corgiolu-labs/uav-lora-transponder/docs/images/schematic.png

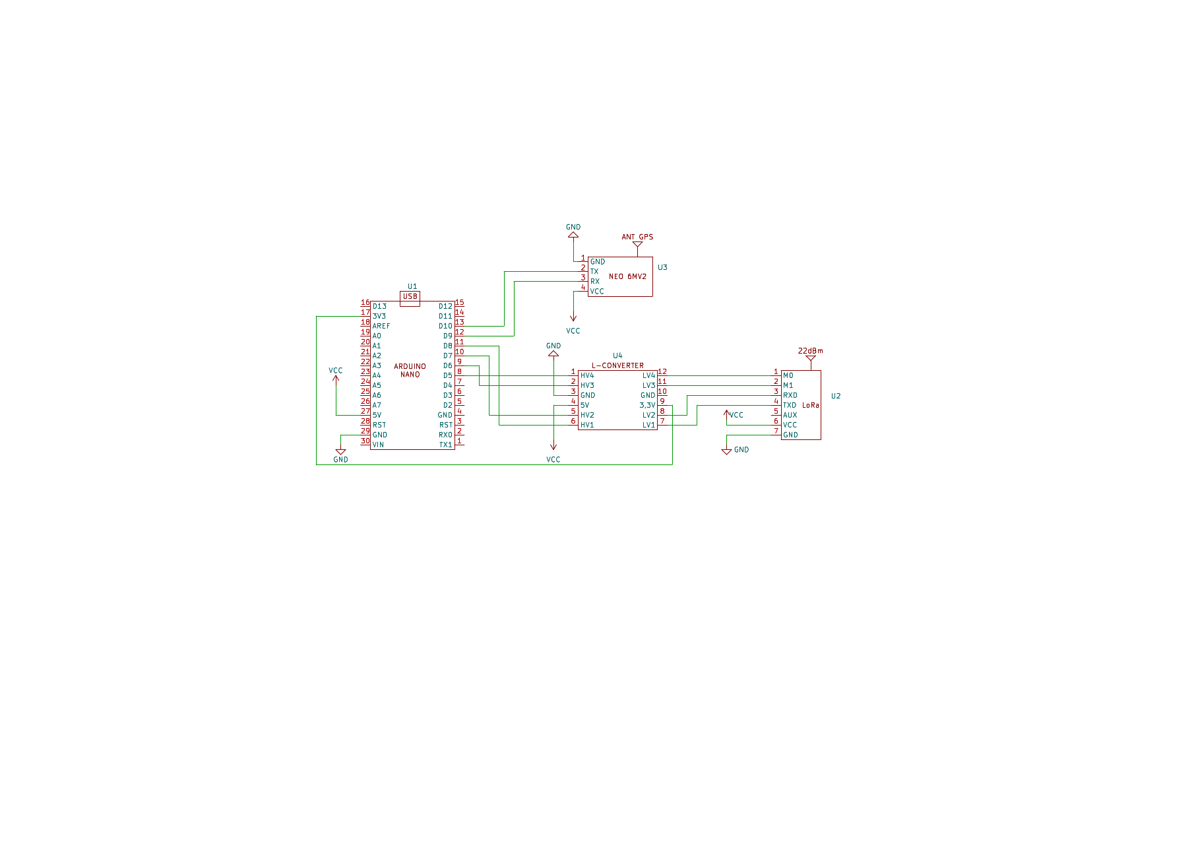
docs/images/schematic.png
