corgiolu-labs/uav-lora-transponder/hardware/schematics/interrogation-station-wiring.pdf

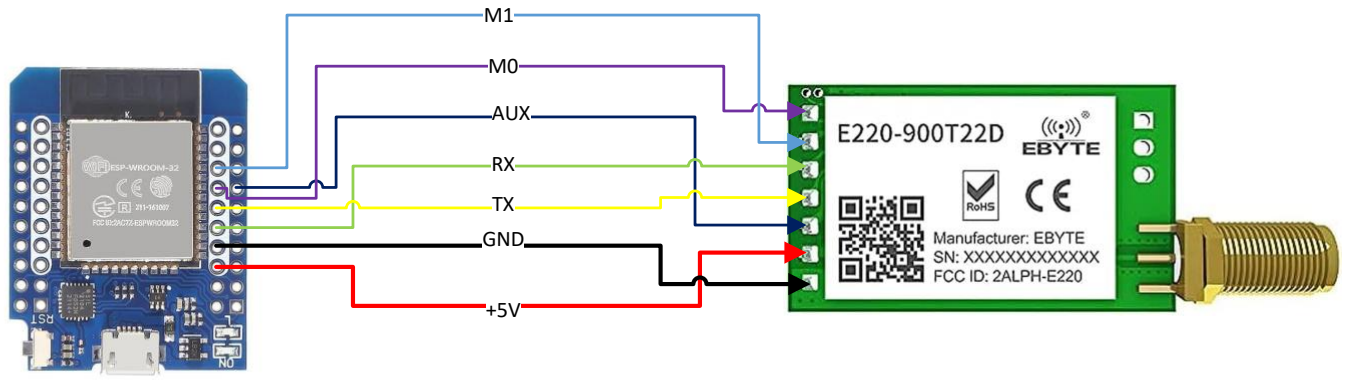
[picture p15: figure]
AUX; GND
