corgiolu-labs/uav-lora-transponder/hardware/schematics/transponder-wiring.pdf

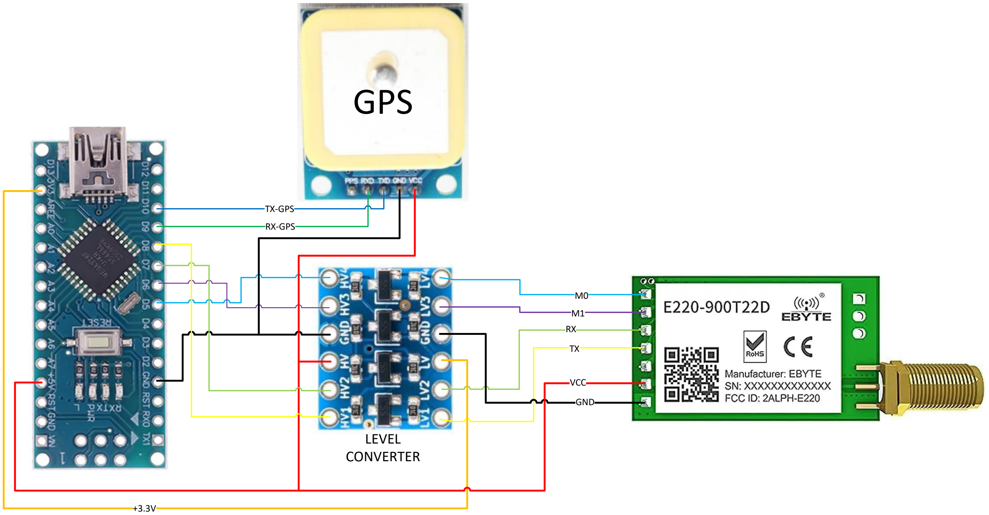
[picture p16: figure]
GND; VCC; GPS; RX-GPS; TX-GPS; LEVEL CONVERTER
