corgiolu-labs/uav-lora-transponder/hardware/schematics/interrogation-station-schematic.pdf

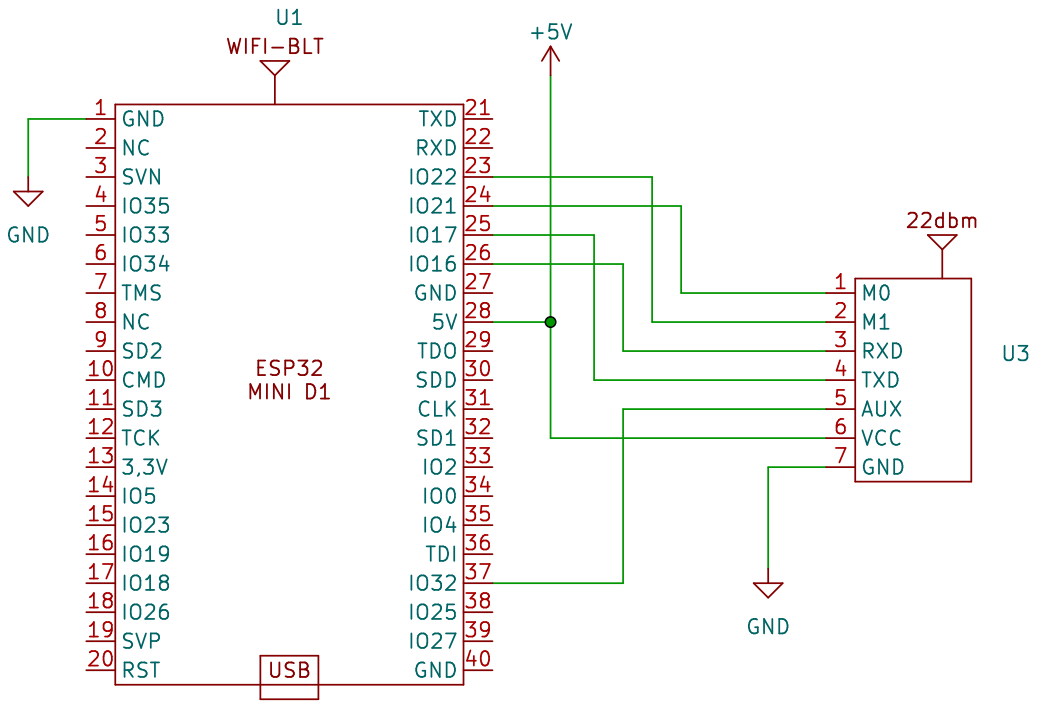
[picture p17: page 1]
