corgiolu-labs/uav-lora-transponder/hardware/schematics/transponder-schematic.pdf

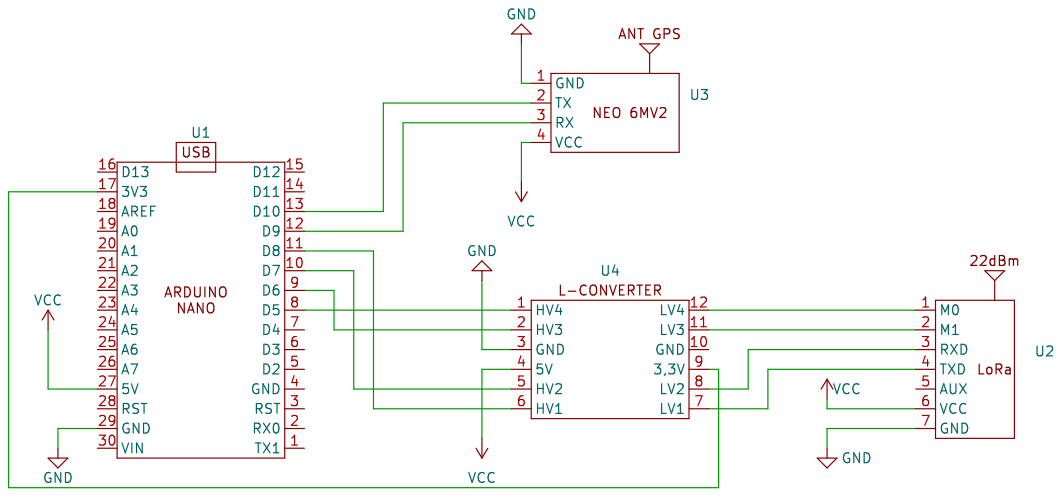
[picture p18: page 1]
