corgiolu-labs/uav-lora-transponder/hardware/enclosures/box-gps.pdf

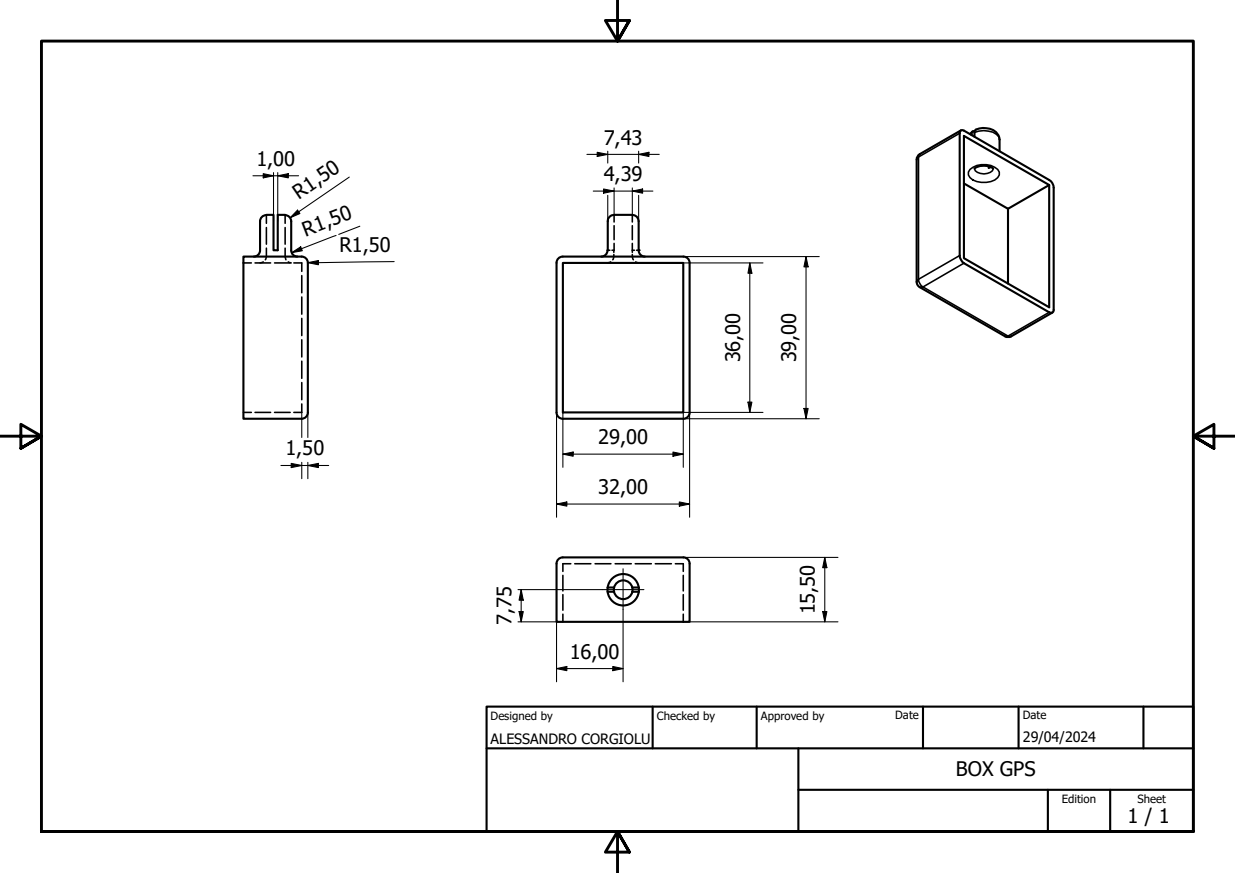
[picture p19: page 1]

Designed by ALESSANDRO CORGIOLU | Checked by | Approved by Date | Date 29/04/2024

BOX GPS

Edition | Sheet 1 / 1
