corgiolu-labs/uav-lora-transponder/hardware/enclosures/box-station.pdf

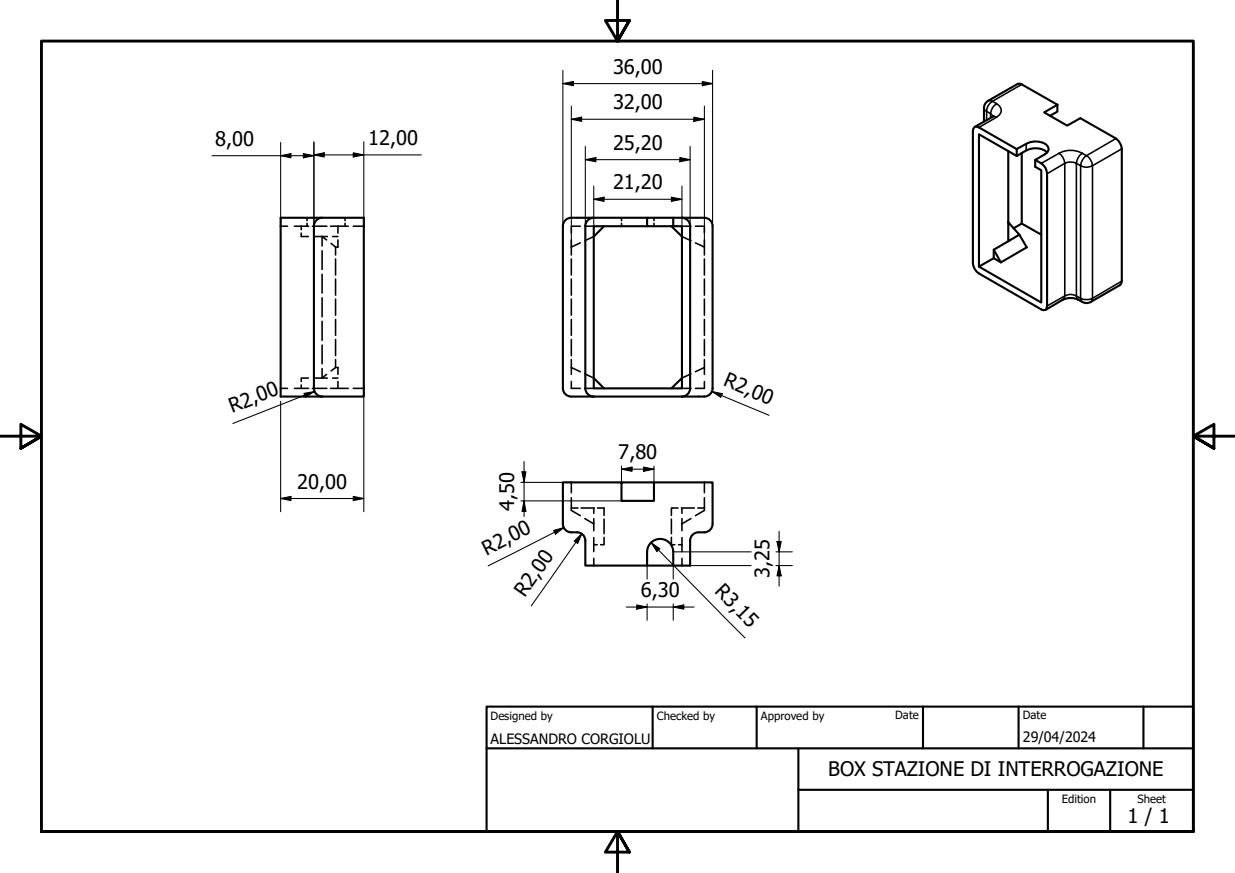
[picture p20: page 1]

Designed by ALESSANDRO CORGIOLU | Checked by | Approved by Date | Date 29/04/2024

BOX STAZIONE DI INTERROGAZIONE

Edition | Sheet 1 / 1
