corgiolu-labs/uav-lora-transponder/hardware/enclosures/box-transponder.pdf

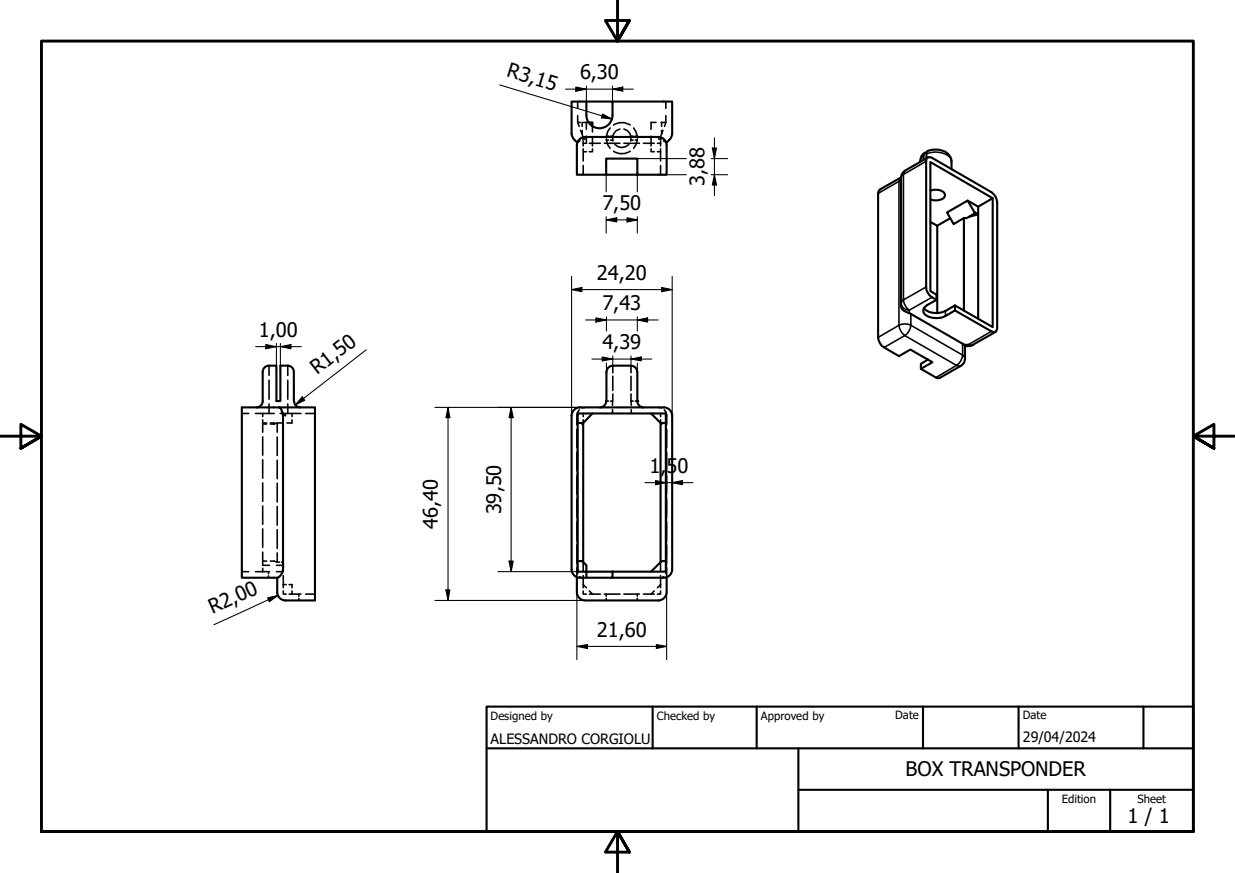
[picture p21: page 1]

Designed by ALESSANDRO CORGIOLU | Checked by | Approved by Date | Date 29/04/2024

BOX TRANSPONDER

Edition | Sheet 1 / 1
