corgiolu-labs/uav-lora-transponder/hardware/enclosures/lid-gps.pdf

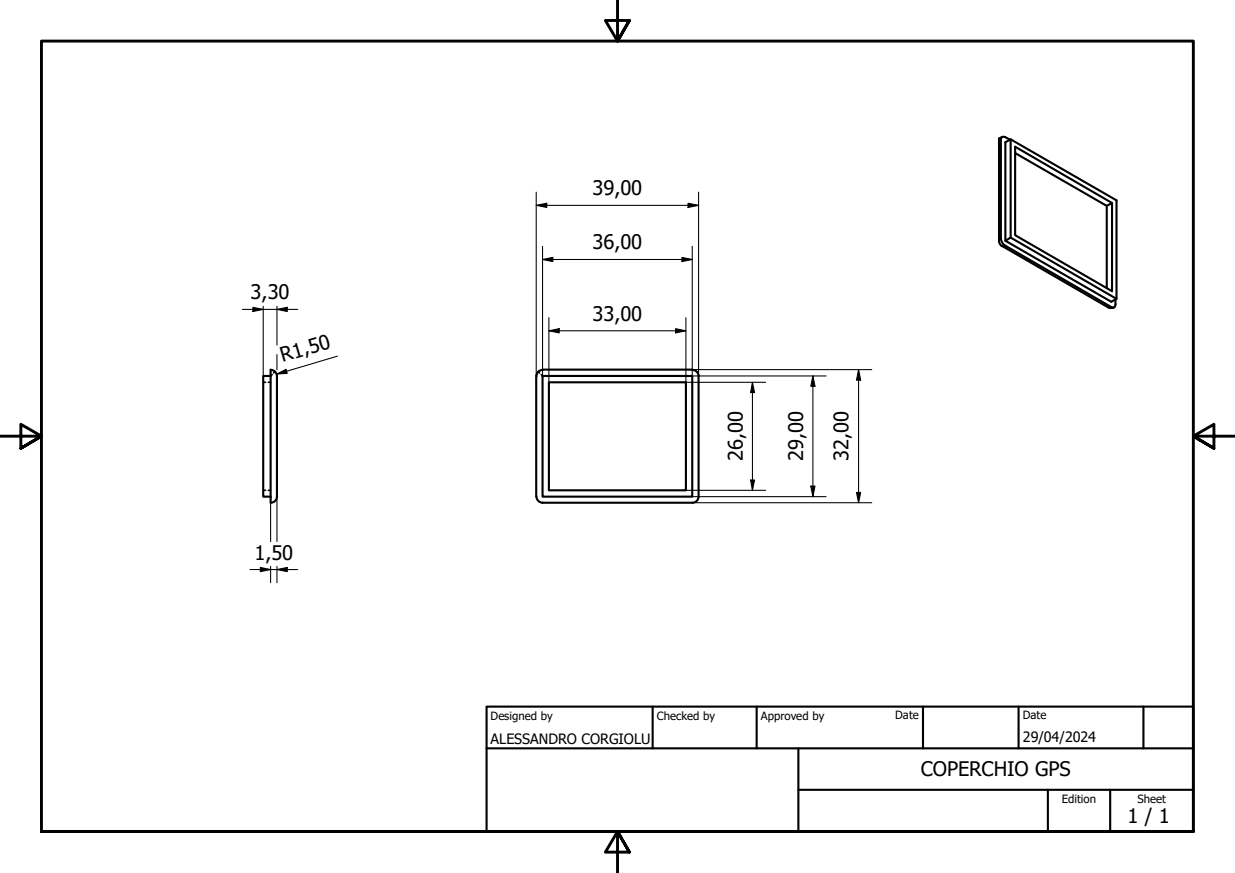
[picture p22: page 1]

Designed by ALESSANDRO CORGIOLU | Checked by | Approved by Date | Date 29/04/2024

COPERCHIO GPS

Edition | Sheet 1 / 1
