corgiolu-labs/uav-lora-transponder/hardware/enclosures/lid-station-esp32.pdf

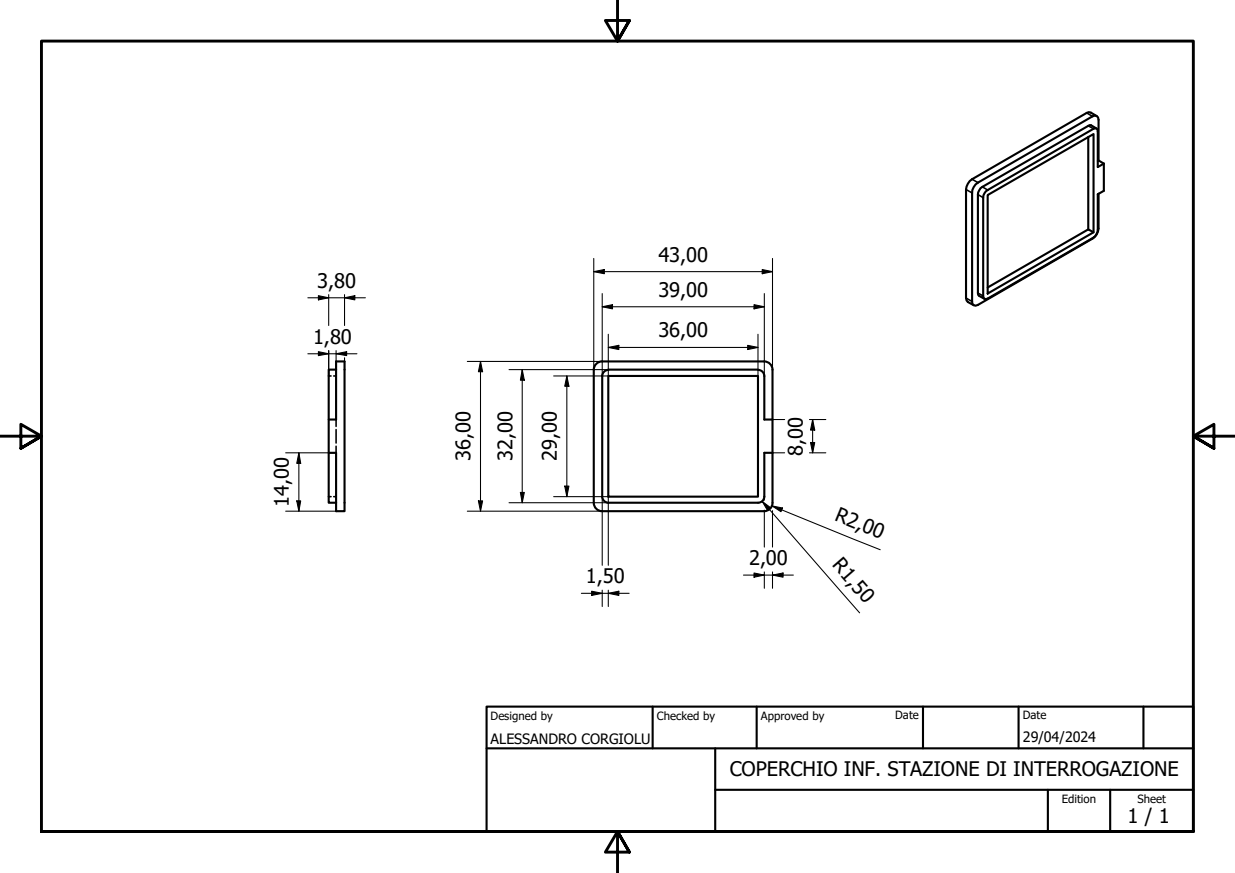
[picture p23: page 1]

Designed by ALESSANDRO CORGIOLU | Checked by | Approved by Date | Date 29/04/2024

COPERCHIO INF. STAZIONE DI INTERROGAZIONE

Edition | Sheet 1 / 1
