corgiolu-labs/uav-lora-transponder/hardware/enclosures/lid-station-lora.pdf

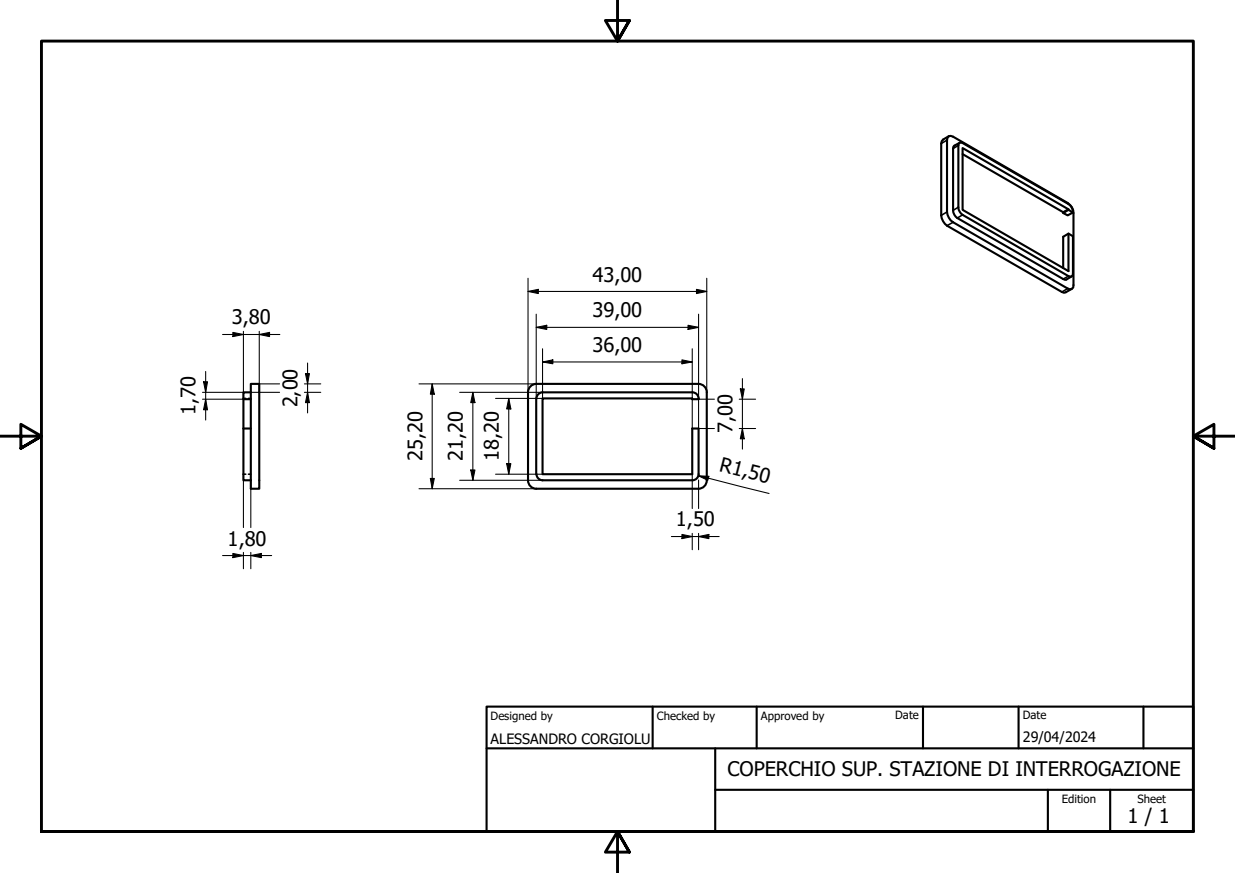
[picture p24: page 1]

Designed by ALESSANDRO CORGIOLU | Checked by | Approved by Date | Date 29/04/2024

COPERCHIO SUP. STAZIONE DI INTERROGAZIONE

Edition | Sheet 1 / 1
