corgiolu-labs/uav-lora-transponder/hardware/enclosures/lid-transponder-lora.pdf

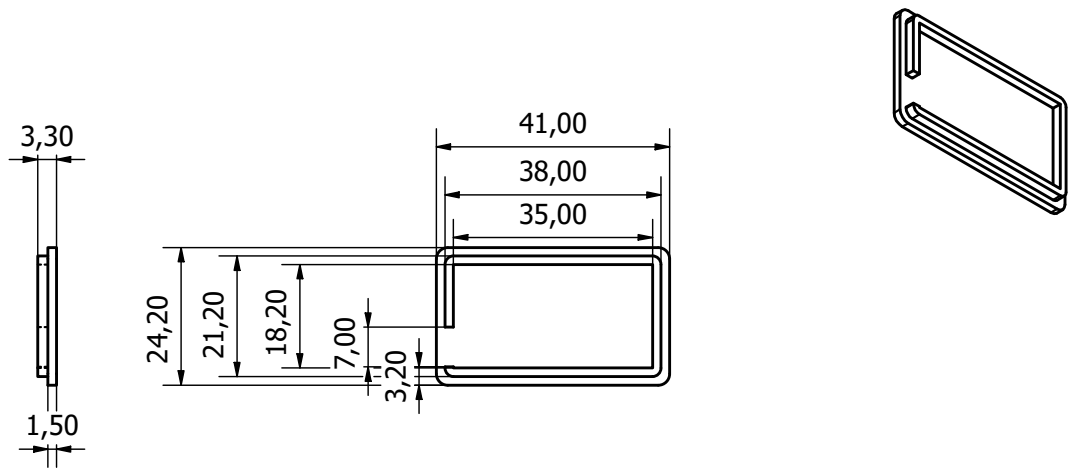
[picture p25: page 1]

Designed by ALESSANDRO CORGIOLU | Checked by | Approved by Date | Date 29/04/2024

COPERCHIO SUP. TRANSPONDER

Edition | Sheet 1 / 1
