corgiolu-labs/uav-lora-transponder/hardware/enclosures/lid-transponder-nano.pdf

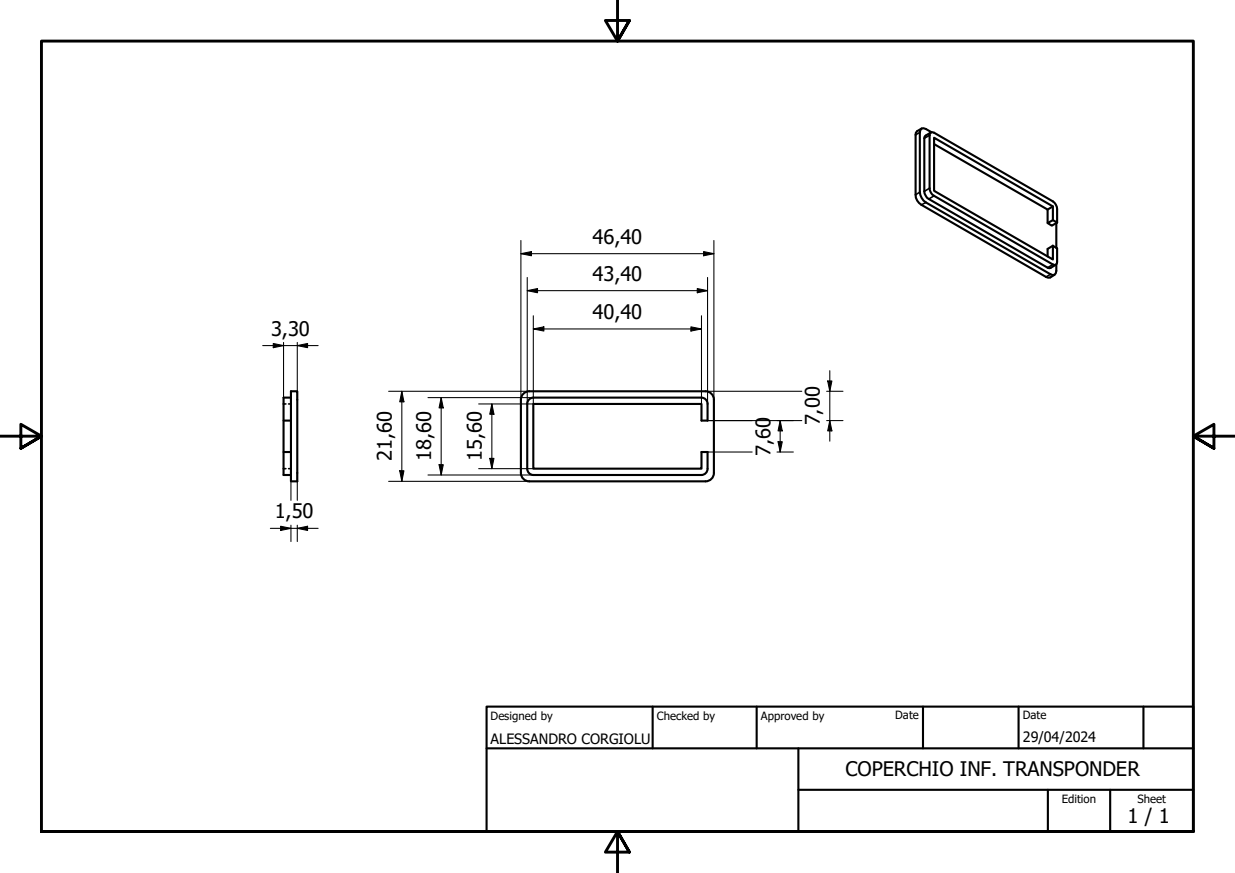
[picture p26: page 1]

Designed by ALESSANDRO CORGIOLU | Checked by | Approved by Date | Date 29/04/2024

COPERCHIO INF. TRANSPONDER

Edition | Sheet 1 / 1
