corgiolu-labs/uav-lora-transponder/transponder/TRANSPONDER/FLOAT_TO_STRING.h

#ifndef _FLOAT_TO_STRING_H

#define _FLOAT_TO_STRING_H




String ftoa(float number, uint8_t precision, uint8_t size) {
  
  String s = "";

  // Negative 
  if (number < 0.0)  {
    s = "-";
    number = -number;
  }

  double rounding = 0.5;
  for (uint8_t i = 0; i < precision; ++i)    rounding /= 10.0;

  number += rounding;
  s += String(uint16_t(number));  // prints the integer part

  if(precision > 0) {
    s += ".";                // prints the decimal point
    uint32_t frac;
    uint32_t mult = 1;
    uint8_t padding = precision -1;
    while(precision--)     mult *= 10;

    frac = (number - uint16_t(number)) * mult;

    uint32_t frac1 = frac;
    while(frac1 /= 10)    padding--;
    while(padding--)      s += "0";

    s += String(frac,DEC) ;  // prints the fractional part
  }

  if (size>0)                // checks size
    if (s.length()>size)        return("#");
    else while(s.length()<size) s = " "+s;

  return s;
}

#endif
