corgiolu-labs/uav-lora-transponder/(commit log)

2026-06-17 Initial commit: BSc thesis - UAV LoRa safety transponder (ESP32/Arduino Nano + E220 + NEO-6 GPS)
2026-06-17 Add photos, KiCad schematic and screenshots to README (hardware, visualizer, validation)
2026-06-17 Add 3D-printed enclosure drawings (CAD) and enclosures section to README
2026-06-17 Add exploded/assembly views and 868 MHz spectrum to README
2026-06-18 Add electrical schematics, wiring diagrams and the full thesis
    hardware/schematics: KiCad schematics + pictorial wiring diagrams for both the interrogation station and the transponder (PDF). README: new 'Schematics & wiring' section (station schematic + both wiring diagrams inline). docs: full BSc thesis (PDF, 77 pages).
2026-06-18 Show the transponder electrical schematic inline (symmetry with the station)
